simenfuglestad/CI-VTS/Hardware/Tempmaaler_kobling.jpg

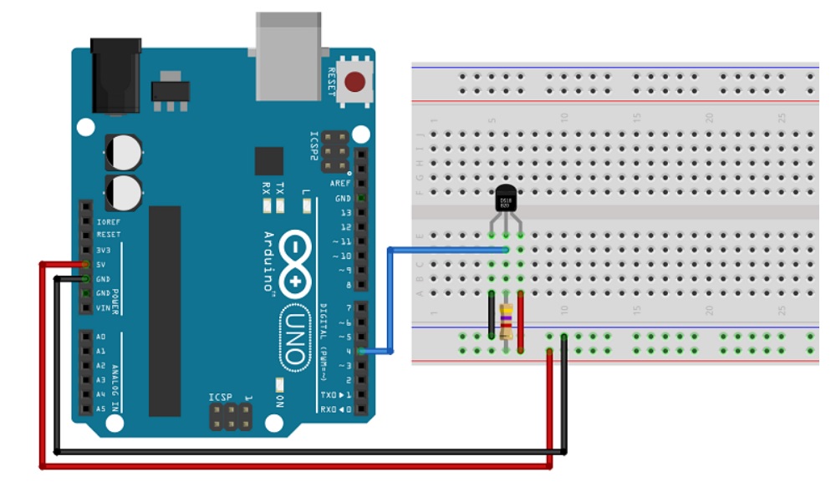
Hardware/Tempmaaler_kobling.jpg
