simenfuglestad/CI-VTS/3D_Files/Camera_Chamber_V2 v9.obj

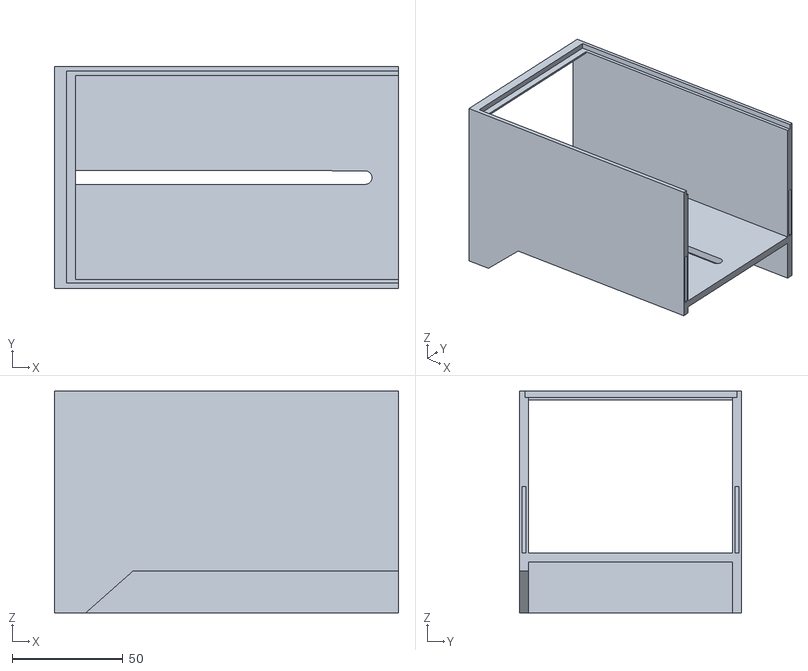
[picture p49: CAD file, 2021-05-31]
3D_Files/Camera_Chamber_V2 v9.obj
155.0 x 100.0 x 100.0
