simenfuglestad/CI-VTS/3D_Files/Electronics Container v2.obj

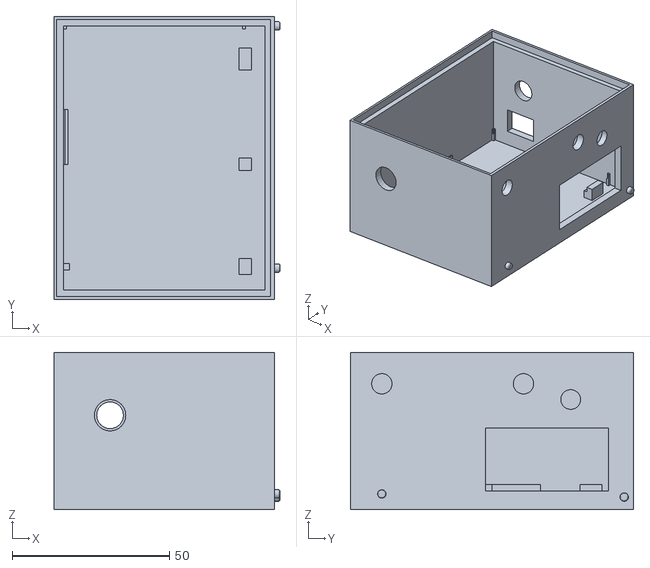
[picture p50: CAD file, 2021-05-31]
3D_Files/Electronics Container v2.obj
71.8 x 90.0 x 50.0
