simenfuglestad/CI-VTS/3D_Files/Spacer 50mm v2.obj

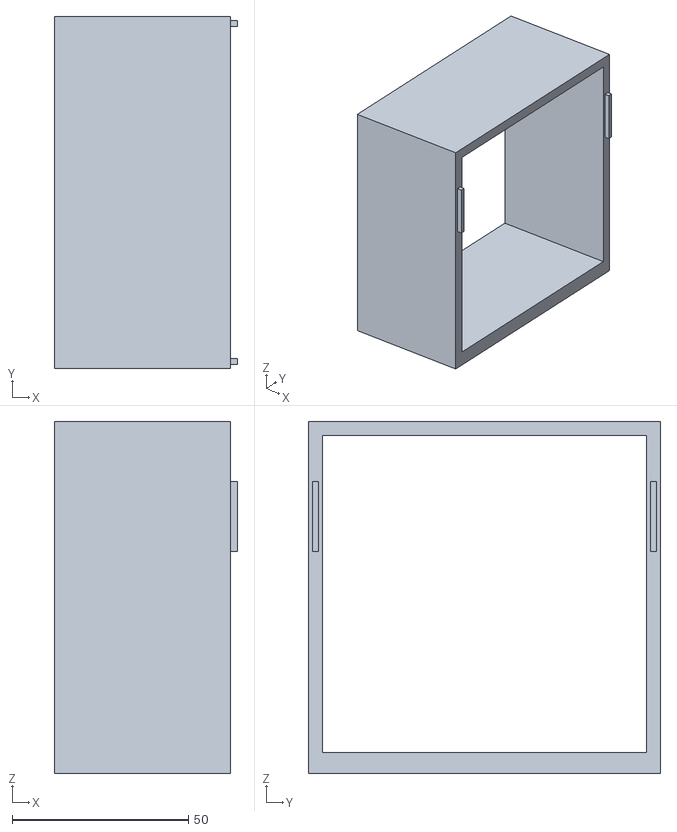
[picture p51: CAD file, 2021-05-31]
3D_Files/Spacer 50mm v2.obj
52.0 x 100.0 x 100.0
