simenfuglestad/CI-VTS/3D_Files/Cuvette lighting V1 v6.obj

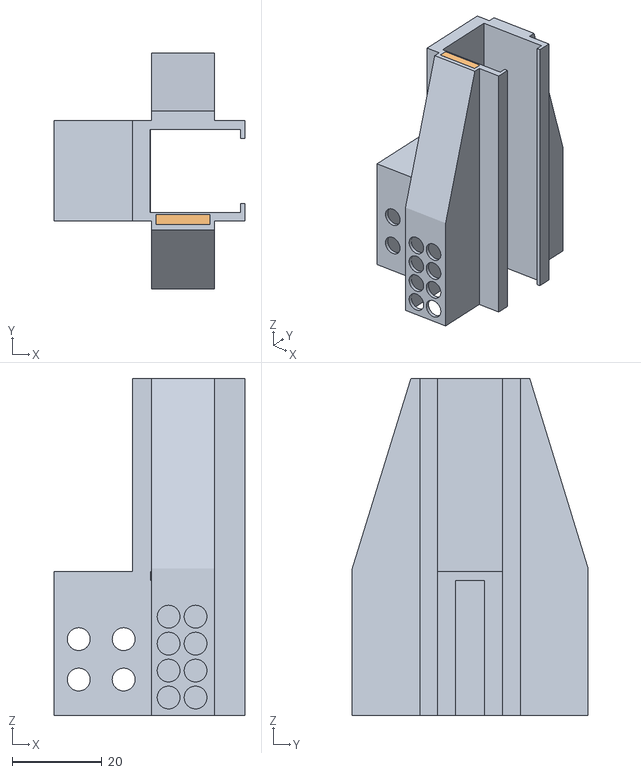
[picture p52: CAD file, 2021-05-31]
3D_Files/Cuvette lighting V1 v6.obj
42.5 x 52.5 x 75.0
