simenfuglestad/CI-VTS/3D_Files/Filter Holder v2.obj

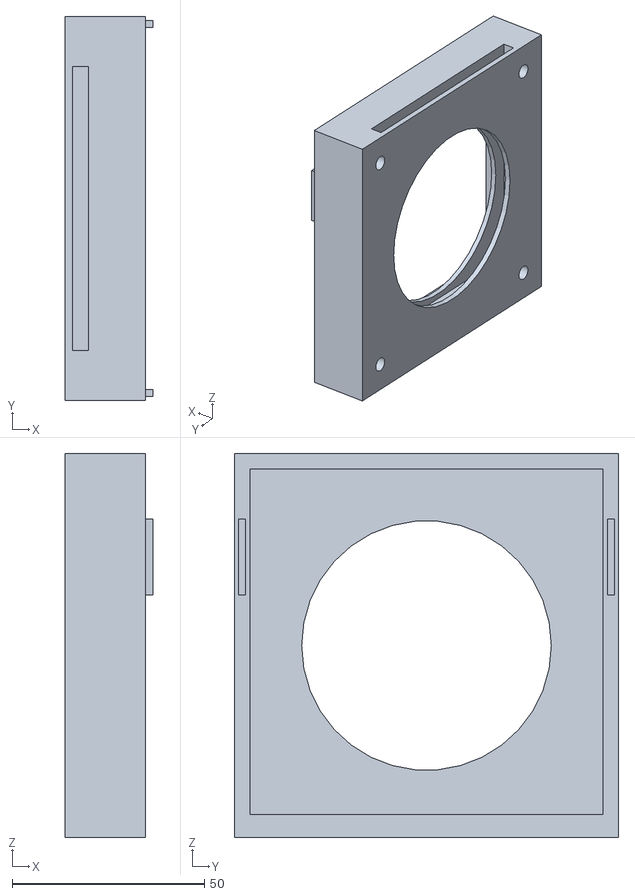
[picture p53: CAD file, 2021-05-31]
3D_Files/Filter Holder v2.obj
23.0 x 100.0 x 100.0
