simenfuglestad/CI-VTS/3D_Files/cuv_Roof_V3 v1.obj

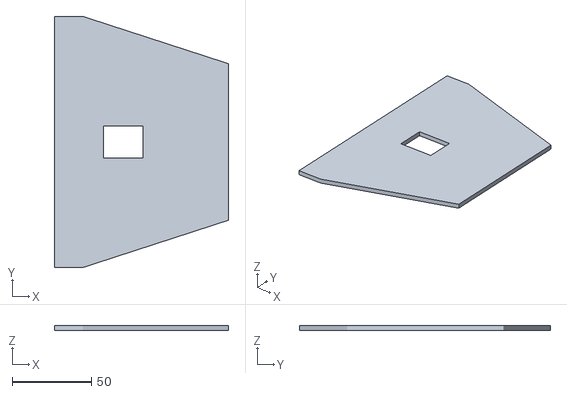
[picture p54: CAD file, 2021-05-31]
3D_Files/cuv_Roof_V3 v1.obj
109.8 x 158.0 x 3.00
