simenfuglestad/CI-VTS/3D_Files/Spacer 200mm v2.obj

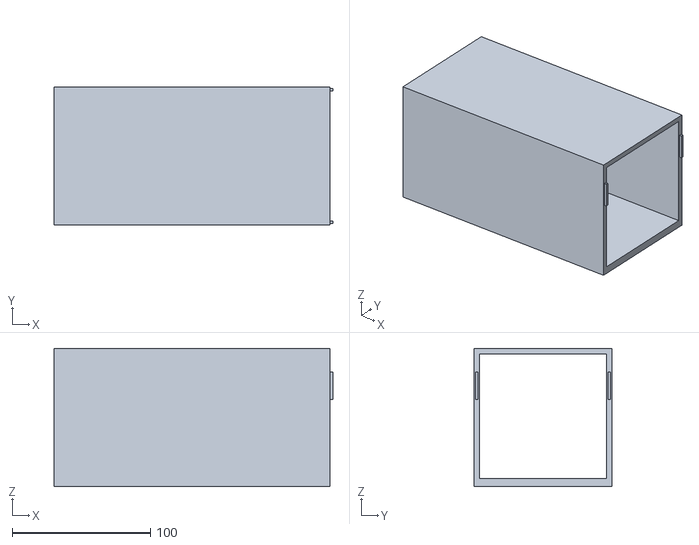
[picture p55: CAD file, 2021-05-31]
3D_Files/Spacer 200mm v2.obj
202.0 x 100.0 x 100.0
