simenfuglestad/CI-VTS/3D_Files/Spacer 100mm v1.obj

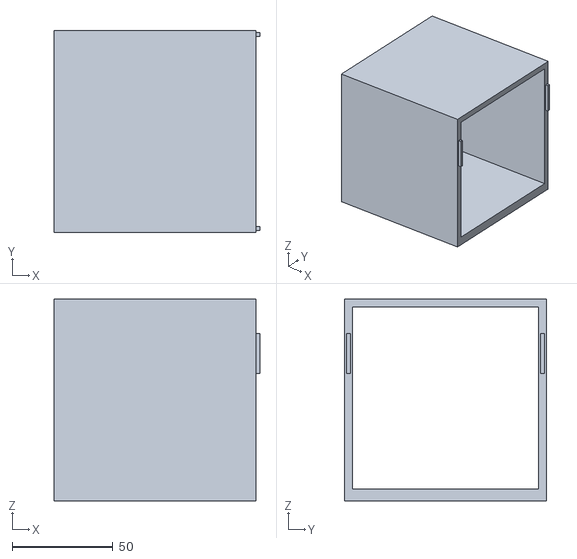
[picture p56: CAD file, 2021-05-31]
3D_Files/Spacer 100mm v1.obj
102.0 x 100.0 x 100.0
