simenfuglestad/CI-VTS/3D_Files/COB_asse_V1 v1.obj

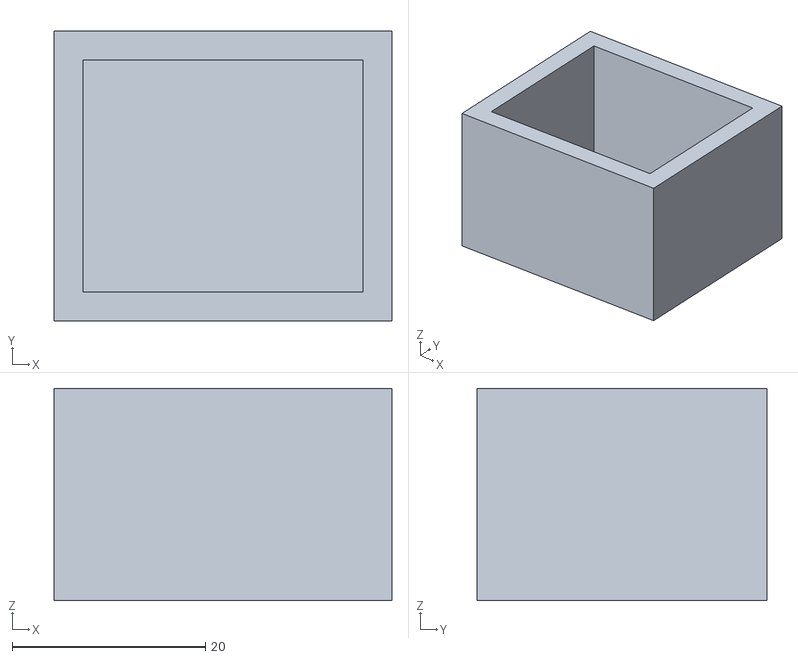
[picture p57: CAD file, 2021-05-31]
3D_Files/COB_asse_V1 v1.obj
35.0 x 30.0 x 22.0
