simenfuglestad/CI-VTS/3D_Files/Cam_Back v3.obj

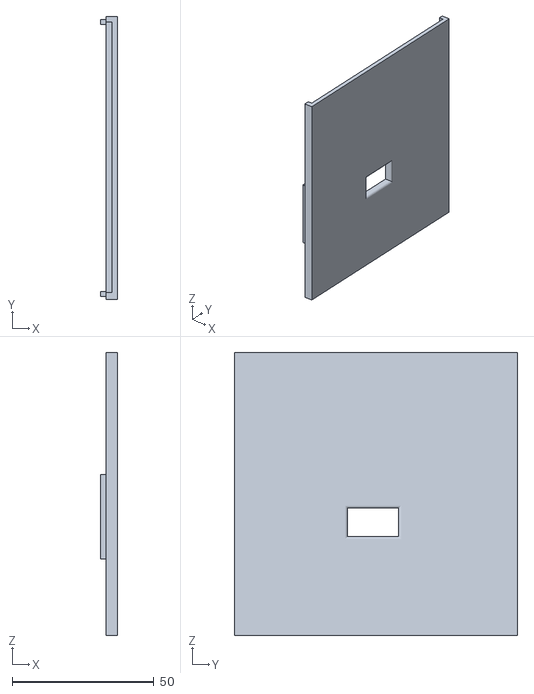
[picture p58: CAD file, 2021-05-31]
3D_Files/Cam_Back v3.obj
6.00 x 100.0 x 100.0
