simenfuglestad/CI-VTS/3D_Files/Cam_Roof V3 v2.obj

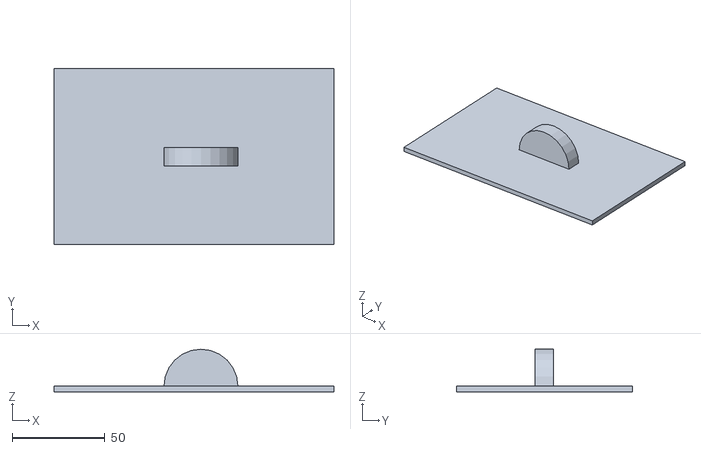
[picture p59: CAD file, 2021-05-31]
3D_Files/Cam_Roof V3 v2.obj
151.3 x 95.3 x 23.0
