simenfuglestad/CI-VTS/3D_Files/Electronics container Roof v2.obj

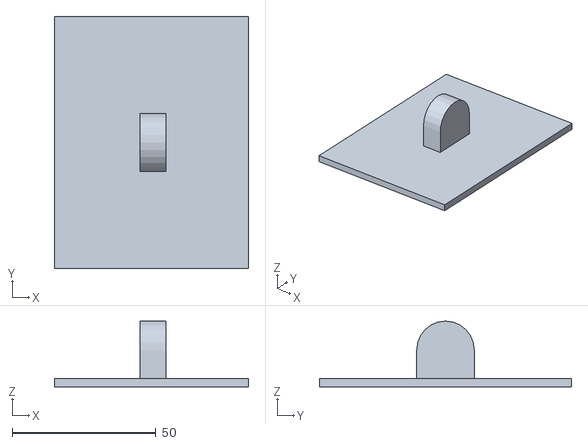
[picture p60: CAD file, 2021-05-31]
3D_Files/Electronics container Roof v2.obj
67.6 x 87.6 x 22.9
