simenfuglestad/CI-VTS/3D_Files/Cuvette chamber V4 v4.obj

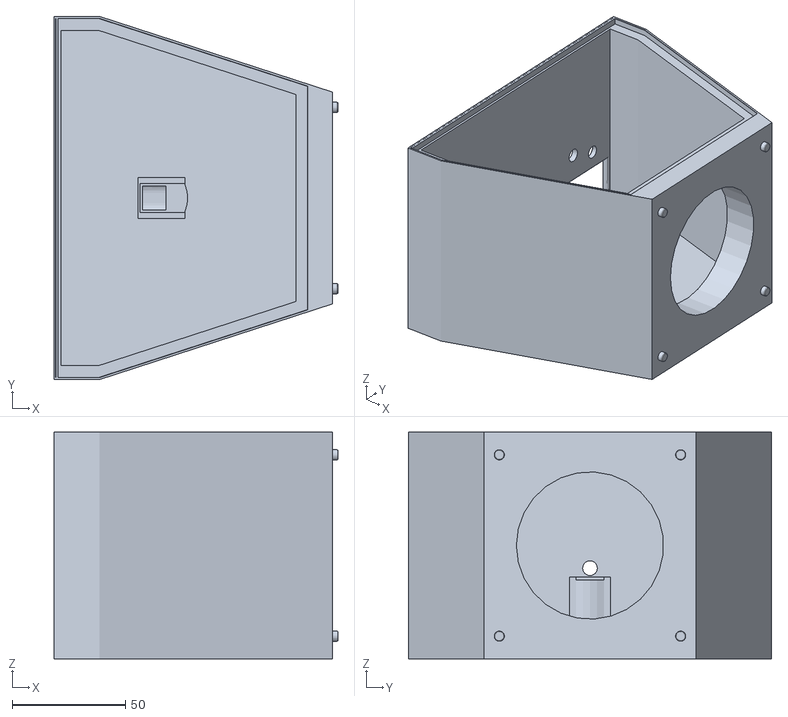
[picture p61: CAD file, 2021-05-31]
3D_Files/Cuvette chamber V4 v4.obj
125.3 x 160.3 x 100.0
