simenfuglestad/CI-VTS/(threads)

Thread 14 (2021-03-11):

Frequent use of pyserial write with slider bar freezes execution loop

xorfindude, 2021-03-11:
Suggested fix: Implement queue to handle excessive write calls in serial interface

xorfindude, 2021-03-15:
Resolved: Serial write calls were bottle-necked when using arduino Uno, final product should rely on Nano which does not have this issue.

Closed 2021-03-15.

Thread 30 (2021-04-09):

Recording experiment sometimes skip an unreasonable amount of frames

simenfuglestad, 2021-04-09:
System: Observed on Windows, though potential problem for any system

Steps to reproduce:
- Run CI-VTS
- Plot stimulus data of any significant length, typically above 20-25 secs
- Run experiment, then wait for it to finish

Result: Sometimes results in dramatically fewer frames than expected, can be verified in console or by playing new recording. I.e in a 24s run only ~750 frames were recorded, as opposed to the expected 1440.

simenfuglestad, 2021-04-14:
This issue appears to be caused by both of the following:
1. Setting the camera to record a very high framerate, typically > 120.
2. Connecting the camera via USB2.0, which is unsupported by manufacturer, or sometimes via USB hubs.

Anyone experiencing this issue should try lowering the framerate and verifying that the camera is connected via USB3.0 all the way through, hubs included.

Keeping this issue open for now in case further development reveals more information.

Closed 2021-05-31.

Thread 36 (2021-04-13):

Setting start of stimulus after time=0 does not work, still starts at 0

simenfuglestad, 2021-04-13:
Platform: Any

Steps to reproduce:
1. Plot any stimulus with intensity > 0 for any duration at start time > 0
2. Run

Expected behavior: Stimulus LED should be of until the set time

Resulting behavior: Stimulus LED turns on immediately

Closed 2021-04-13.

Thread 41 (2021-04-15):

Correct behavior of running experiments

simenfuglestad, 2021-04-15:
Currently only possible to run a single experiment, implement sequential running of all experiments in "experiments to run"

Thread 42 (2021-04-15):

Serial interface often detects erroneous devices and lists them in addition to correct device

simenfuglestad, 2021-04-15:
Proposed solutiuon: Add verification protocoll during scan of serial interface where Arduino can signal that it is the correct device
