simenfuglestad/CI-VTS/Hardware/Schematic_CI-VTS control circuit_2021-05-27 (1).pdf

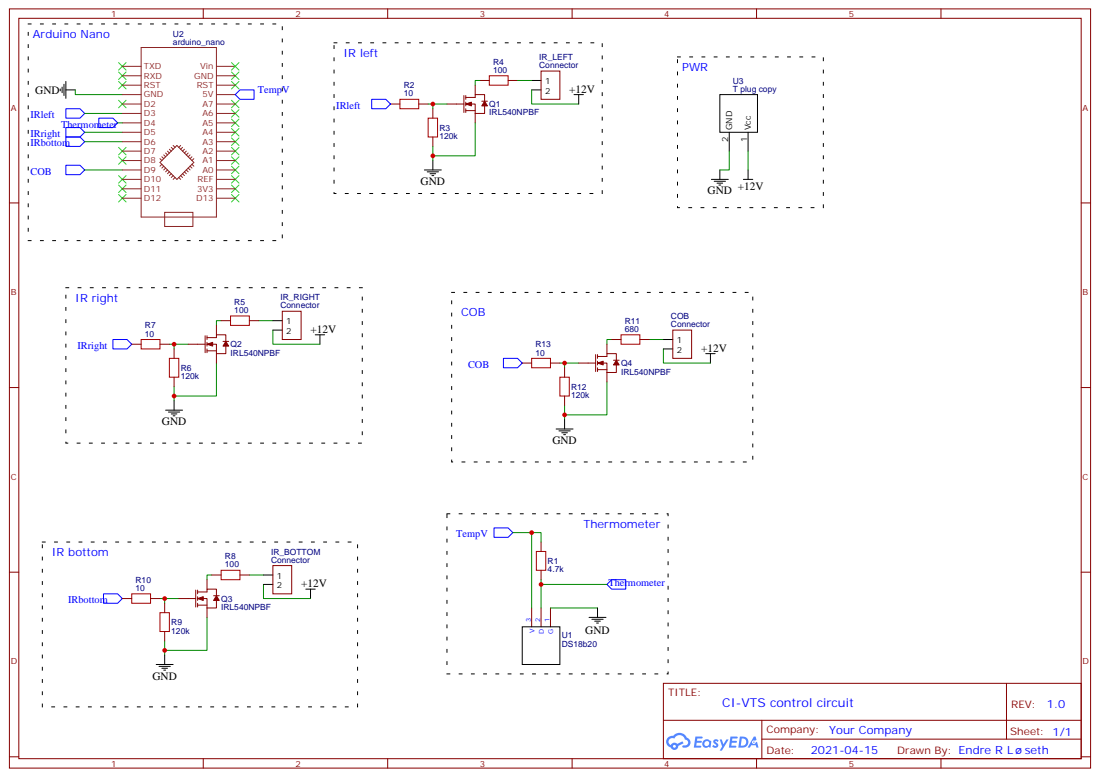
[picture p62: page 1]

Drawn By: Endre R L seth
