simenfuglestad/CI-VTS/src/arduino/arduino.py

class Arduino(object):
    """
    ATTENTION: This class is a dud and probably due for removal, however it remains until further decisions on software
    design have been mapped out
    """
    def __init__(self):
        pass
