simenfuglestad/CI-VTS/(commit log)

2021-03-12 Added arduino source code, improved connection handling
2021-03-15 Added save and delete of stimulus profiles, fixed view of saved profiles with new data format
    [MainWindow.py]
2021-03-18 Added experiment running with LED stimulus
2021-03-18 Added LED boundaries when runnning
2021-03-18 Added quick fix to properly set final LED value to 0 or 1
2021-03-20 Added files used for 3D printing
    [Camera mount v3.obj, Camera_Chamber_Roof v1.obj, Camera_Chamber_V1 v1.obj, Camera_Chamber_V2 v3.obj, Cuvette chamber V3 v3.obj, Cuvette lighting V1 v6.obj, Cuvette roof V2 v1.obj, Cuvette roof V2 v2.obj]
2021-03-20 Added camera thread
2021-03-20 Started work on live camera feed
2021-03-20 Added Project to track CI
2021-03-20 Added different filtering methods to reduse noise
2021-03-21 Added simple live camera view
2021-03-23 added circuit for thermometer
2021-03-23 added arduino code for thermometer
2021-03-23 added circuit
    [Design1.ms14]
2021-04-04 Added camera selection and disconnection
2021-04-05 Reworked experiment running to use QTimer, relevant to recording because both stimulus and video capture needs to be encapsulated by timer
    [MainWindow.py, SettingsDialog.py]
2021-04-07 Added recording, recommend rewroking to improve thread safety on video writer
2021-04-08 Reworked camera to enable live view with record, added more features to experiment settings and plotting
    [MainWindow.py, SettingsDialog.py, ui.py]
2021-04-09 Fixed error when setting manual video path
    [MainWindow.py]
2021-04-10 Bugfix to issue #29
    [MainWindow.py]
2021-04-12 Corrected behaviour in scan and connect of camera live feed
    [SettingsDialog.py]
2021-04-12 Improved camera scanning
2021-04-13 Added correct arduino sketch
    [MainWindow.py, MicroControllerCode.ino, SettingsDialog.py, settings_dialog.py, ui.py]
2021-04-13 Bugfix to issue #36, and stimulus should now end when all values are sent to serial interface
    [MainWindow.py]
2021-04-13 Added correct camera fps showing up on startup of settings dialog, fixed bug that would sometimes cause incorrect naming of video files with equals names, lock run button when experiment is running
    [MainWindow.py, SettingsDialog.py]
2021-04-14 Experiment LED now turn off when plotting is done, added COM check for Windows compatibility with arduino
2021-04-14 Cleaned up codebase, disabled UI elements that currently support no functionality
2021-04-15 mior updates to dispaly UI correctly, will fix via designer in dev and remove at later time
    [MainWindow.py, SettingsDialog.py]
2021-04-19 Reverted UI to fix broken file new_design.ui
    [analysis_dialog.py, settings_dialog.py, ui.py]
2021-04-19 Added spacers to move additional settings to top left
2021-04-23 Added analysis button, improved performance of video playback, added play/pause shortcut
    [AnalysisDialog.py, analysis_dialog.py]
2021-04-23 Silenced a print
2021-05-27 Updated sliders and spin boxes to send LED values with correct strings
    [SettingsDialog.py]
2021-05-31 Delete 3D_files directory
    Obsolete files
    [Camera mount v3.obj, Camera_Chamber_Roof v1.obj, Camera_Chamber_V1 v1.obj, Camera_Chamber_V2 v3.obj, Cuvette chamber V3 v3.obj, Cuvette lighting V1 v6.obj, Cuvette roof V2 v1.obj, Cuvette roof V2 v2.obj]
2021-05-31 Delete Preliminary circuits.jpg
    Obsolete
2021-05-31 Delete Design1.ms14
    obsolete
    [Design1.ms14]
2021-05-31 Add files via upload
    Updated picture of control circuit
2021-05-31 Add files via upload
    Up to date design files
    [COB_asse_V1 v1.obj, Cam_Back v3.obj, Cam_Roof V3 v2.obj, Camera_Chamber_V2 v9.obj, Cuvette chamber V4 v4.obj, Cuvette lighting V1 v6.obj, Electronics Container v2.obj, Electronics container Roof v2.obj]
